azallalmohamed/ECOLOGGING/KIM2/Interface Web/Déploiement du Dashboard ECOLOGGING sur Internet (Render).pdf

## Déploiement du Dashboard ECOLOGGING sur Internet (Render)

## 1. Objectif :

L’objectif est de rendre accessible sur Internet une plateforme web permettant :

Cette plateforme constitue le centre de supervision du système ECOLOGGING Satellite Station.

## 2. Choix de la plateforme d’hébergement :

La plateforme Render a été choisie car elle permet :

Lien :
https://render.com

## 3. Création du compte Render :

la récupération des données satellite CLS le stockage des mesures environnementales l’affichage en temps réel
la visualisation graphique des données l’accès public via navigateur web

Hébergement gratuit
Déploiement rapide
Support Python/Flask
HTTPS sécurisé
Accès public mondial
1. Accéder au site Render
2. Cliquer sur Get started
3. Se connecter avec Google ou GitHub

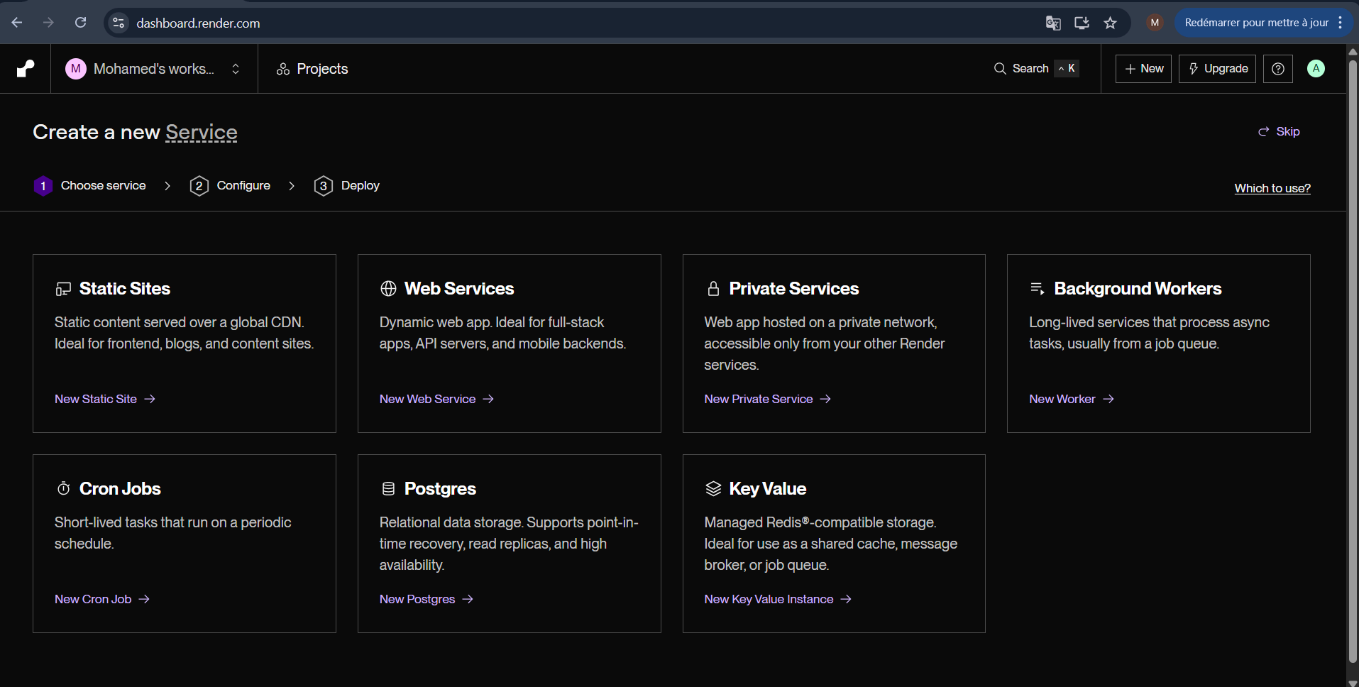
[picture p38: figure]

## 4. Création du dépôt GitHub :

Afin de déployer le projet, un dépôt GitHub est nécessaire.

### Étapes :

4. Accéder au tableau de bord Render :
1. Aller sur : https://github.com/new
2. Nom du dépôt :

ecologging-dashboard

3. Choisir Public
4. Cliquer sur Create repository

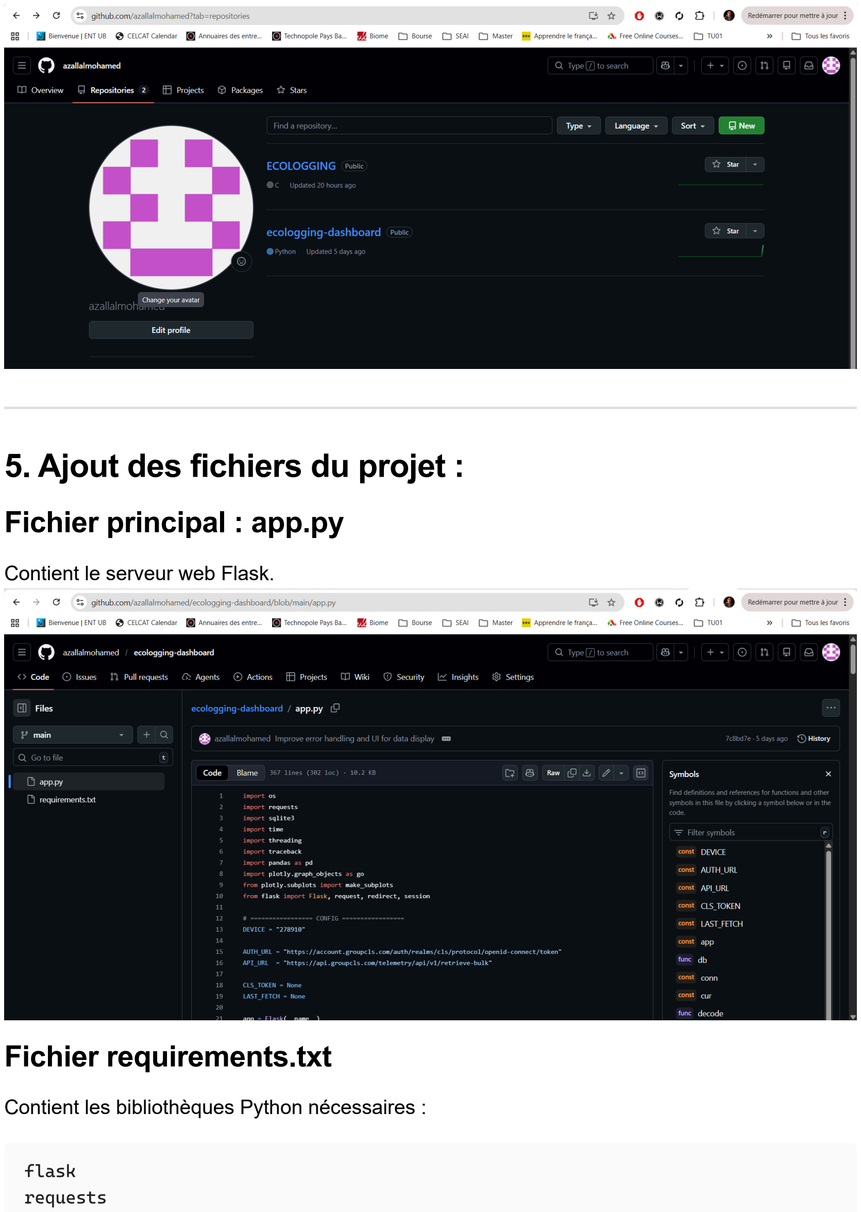
[picture p39: page 3]

## 5. Ajout des fichiers du projet :

## Fichier principal : app.py

Contient le serveur web Flask.

## Fichier requirements.txt

Contient les bibliothèques Python nécessaires :

flask

requests

Ces fichiers sont envoyés sur GitHub.

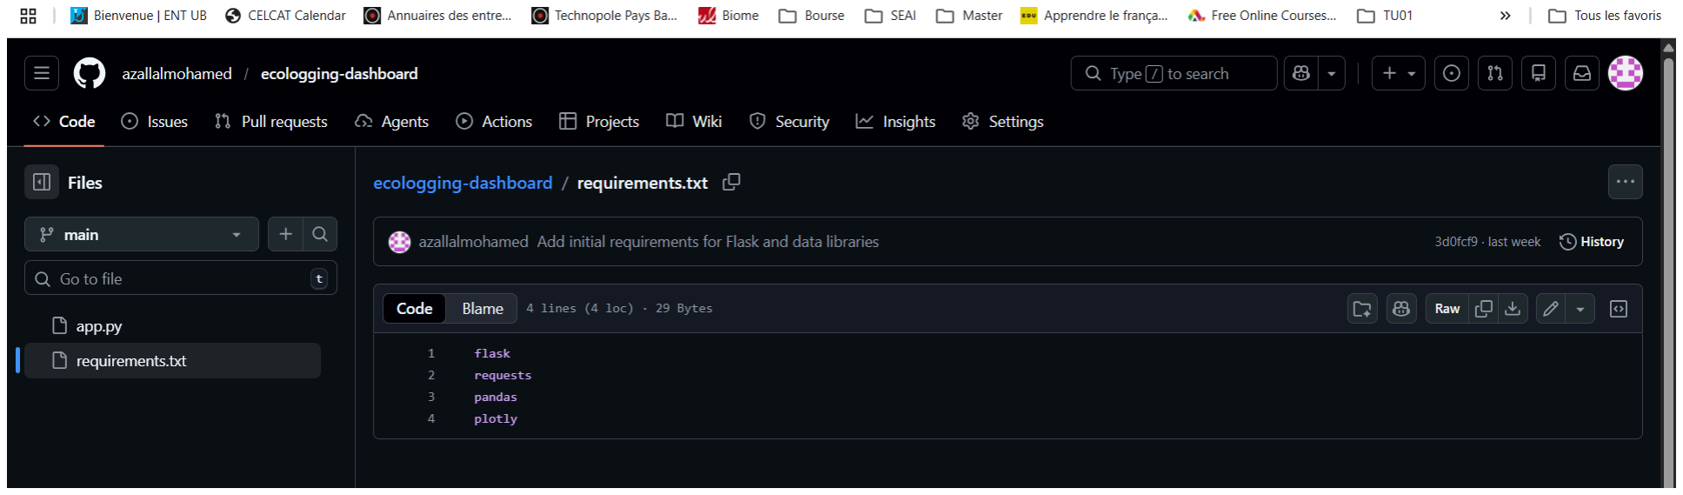
[picture p40: figure]

## 6. Création du Web Service sur Render :

Dans le tableau de bord Render :

## 7. Configuration du service :

Paramètres utilisés :

Paramètre | Valeur
Name | ecologging
Environment | Python
Build command | pip install -r requirements.txt
Start command | python app.py

pandas
plotly
1. Cliquer sur New +
2. Choisir Web Service
3. Connecter GitHub
4. Sélectionner :

ecologging-dashboard

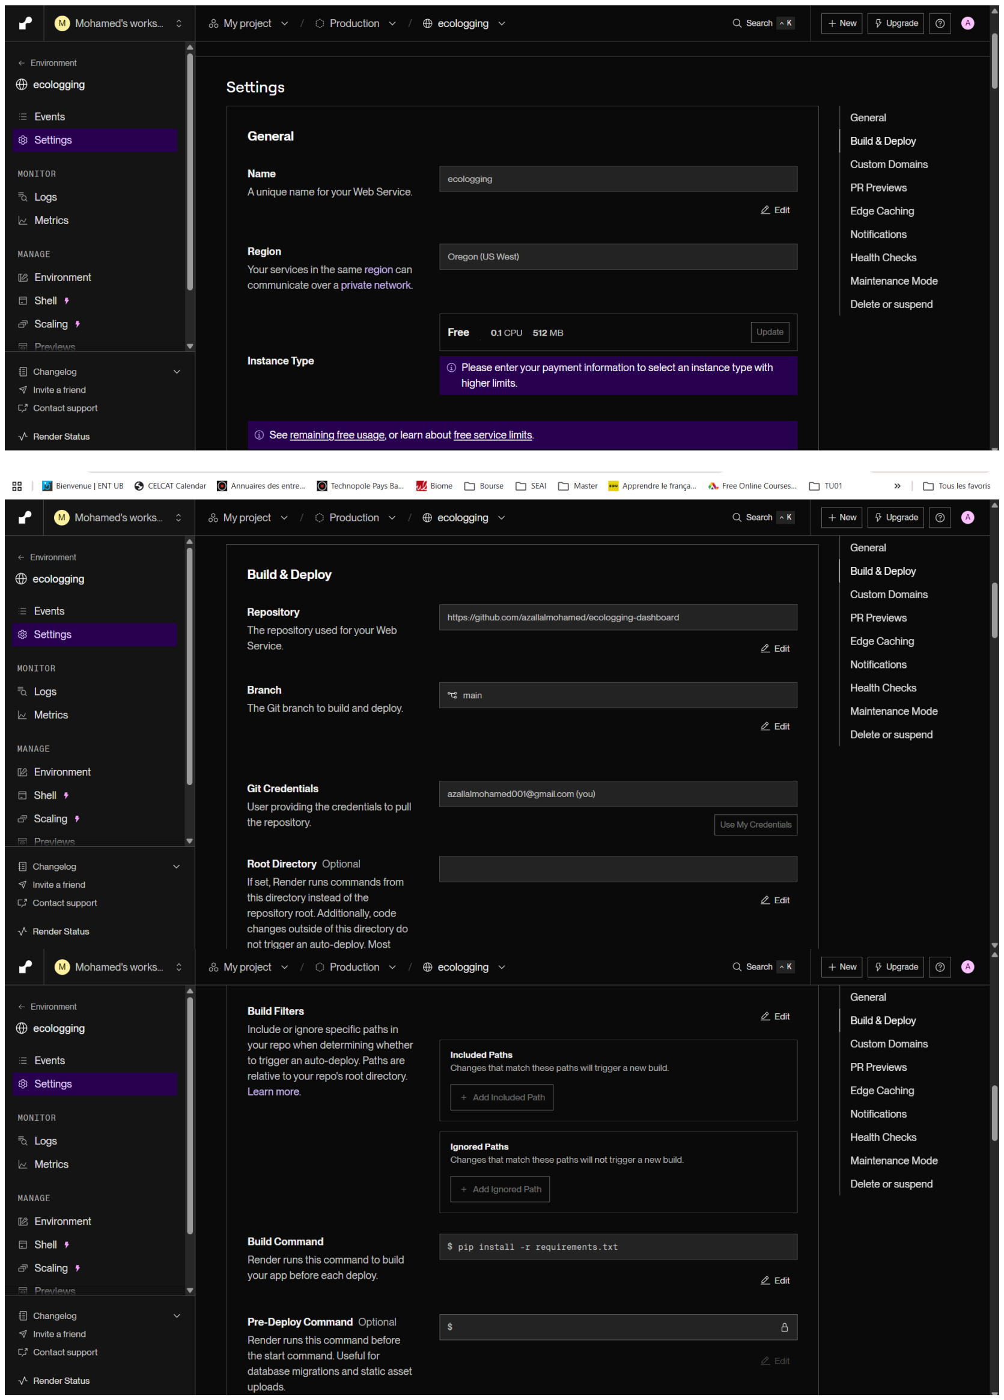
[picture p41: page 5]

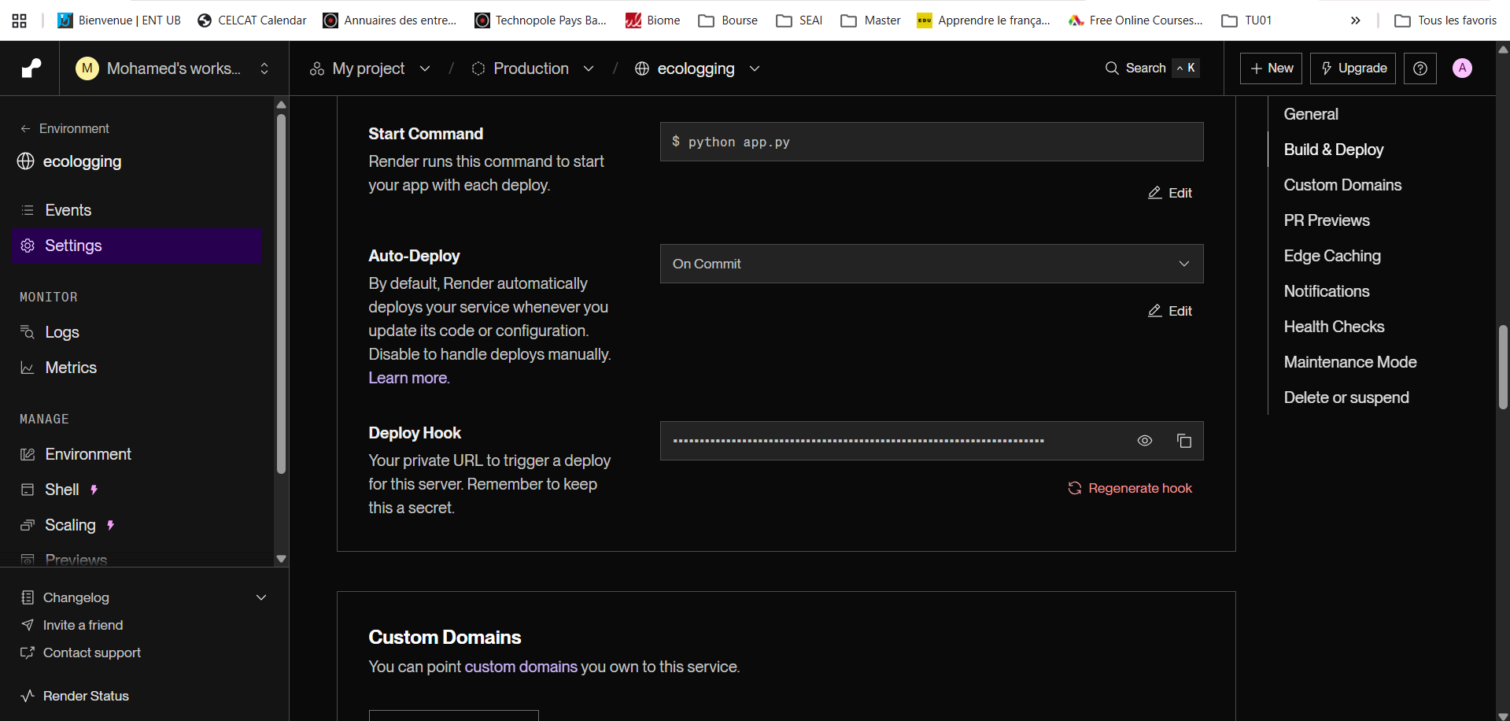
[picture p42: figure]

Puis cliquer sur :

Render déploie automatiquement le serveur.

## 8. Mise en ligne :

Après déploiement, Render génère une URL publique :

Cette URL permet d’accéder au dashboard depuis n’importe quel navigateur.

## 9. Fonctionnement global :

Le système complet fonctionne comme suit :

Create Web Service

https://ecologging.onrender.com

CLS → API → Serveur Render → Base de données

## 10. Résultat :

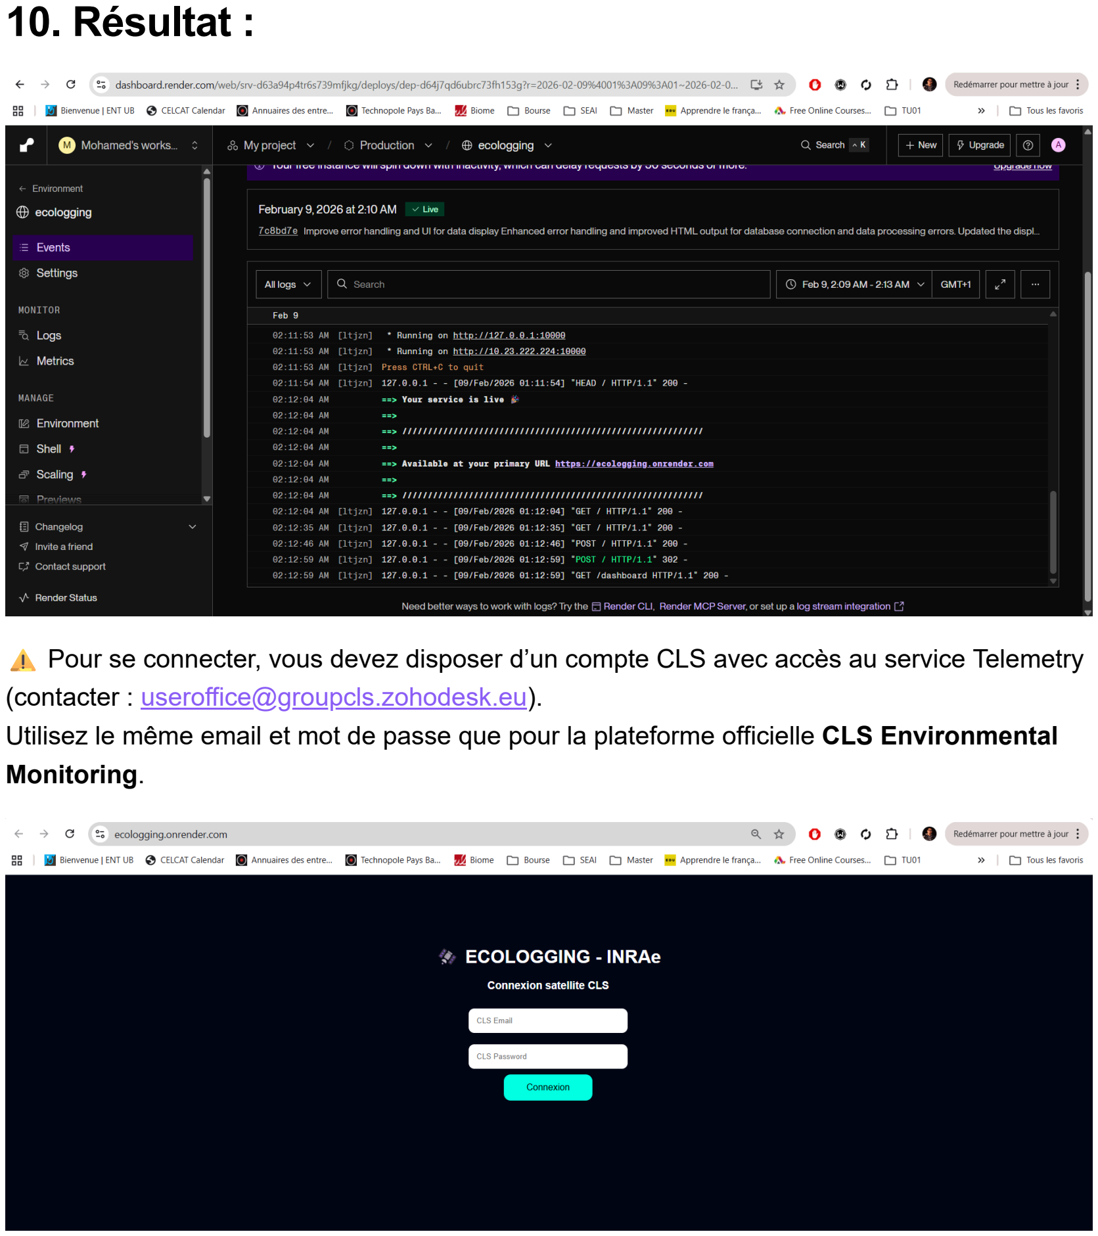
[picture p43: page 7]

⚠️ Pour se connecter, vous devez disposer d’un compte CLS avec accès au service Telemetry

(contacter : useroffice@groupcls.zohodesk.eu).
Utilisez le même email et mot de passe que pour la plateforme officielle CLS Environmental Monitoring.

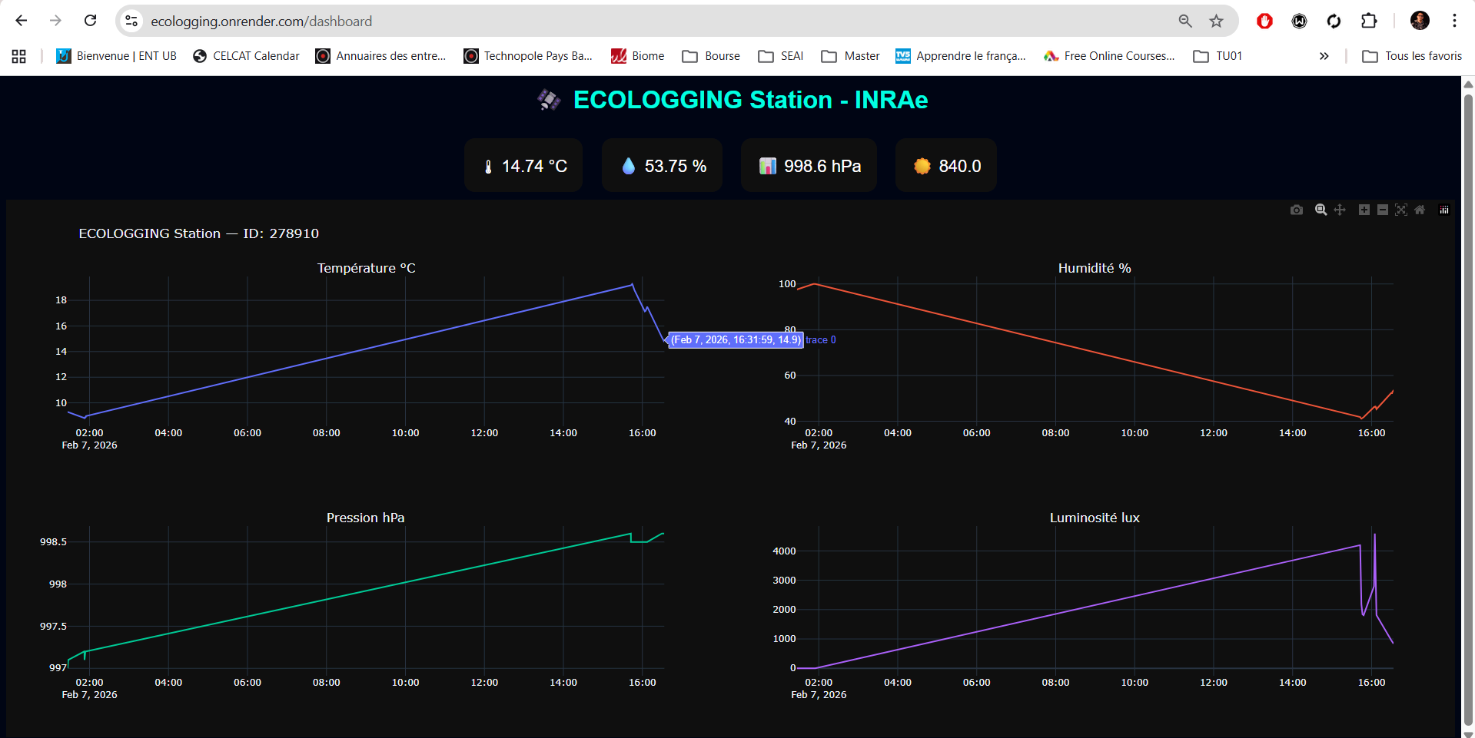
[picture p44: figure]
